Nicronixs/Labor_Oszi/protokoll/Protokoll.pdf

# Aufbau eines eigenen Oszilloskops

### Sonja Schönauer, Nicolas Scherrer 4BHEL

### 26. September 2025

1

## Inhaltsverzeichnis

1 Zielsetzung | 4
2 Blockschaltbild | 5
3 Theoretische Grundlagen | 5
4 Aufbau der Grundschaltung | 8
5 Spannungsquelle VCC kurzgeschlossen | 9
6 Spannungsquelle UE kurzgeschlossen | 10
7 Berechnungen | 11
7.2.2 | UA prufen rechnerisch: | ¨ | 14
7.2.3 | UA prufen mit Simulation: | ¨ | 14
7.3.2 | UA prufen rechnerisch: | ¨ | 17
7.3.3 | UA prufen mit Simulation: | ¨ | 18
7.4.2 | UA prufen rechnerisch: | ¨ | 21
7.4.3 | UA prufen mit Simulation: | ¨ | 22

2

8 Schaltplan | 32

3

## Aufgabenstellung

Entwurf eines analogen Front Ends (AFE) fur ein Oszilloskop, das folgende Ein- ¨ gangssignale verarbeitet:

- ±36 V
- ±10 V
- ±1 V
Die Signale sollen fur einen Mikrocontroller ( ¨ | µC) mit einem ADC-Eingangsspannungsbereich
von 0 V bis 3,3 V aufbereitet werden.

## 1 Zielsetzung

- Skalierung der drei unterschiedlichen Eingangsspannungsbereiche auf eine Ausgangsspannung UA (0 V bis 3,3 V)..
- Signalverschiebung (Offset), um negative Eingangsspannungen in den positiven Spannungen zu wandeln.

4

## 2 Blockschaltbild

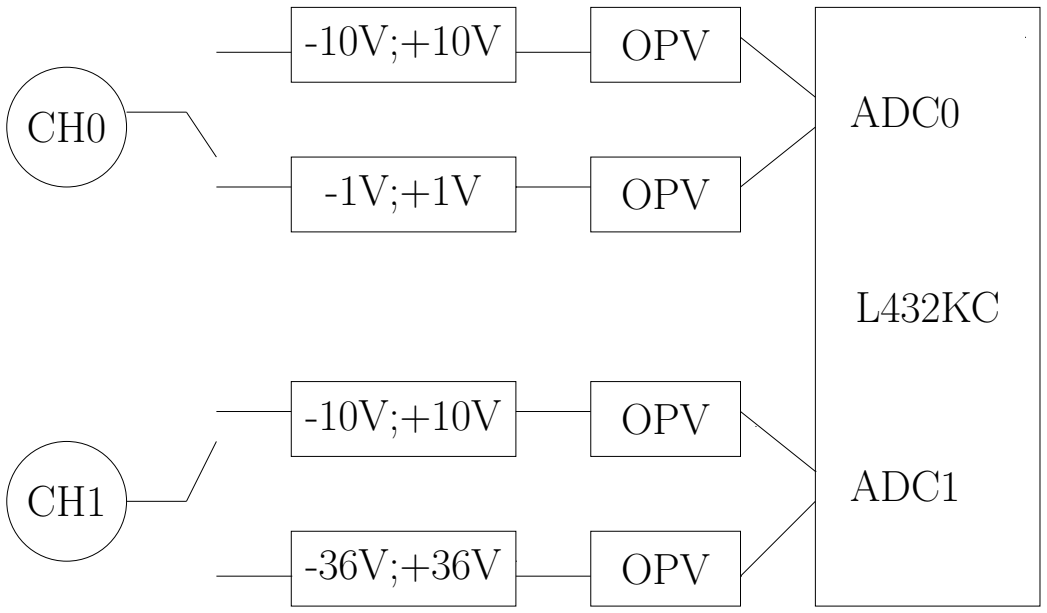
[picture p1: figure]
OPV; ADC0; ADC1

Abbildung 1: Blockdiagramm des Projekts

## 3 Theoretische Grundlagen

### 3.1 Was ist ein Oszilloskop?

Ein Oszilloskop (kurz: Oszi) ist ein Messgerät, das elektrische Spannungsverläufe sichtbar macht. Es zeigt, wie sich eine Spannung in Abhängigkeit von der Zeit verändert. Dadurch können schnelle Signalformen dargestellt und analysiert werden.

### 3.1.1 Was ein Oszilloskop kann

- Spannungsverläufe anzeigen: Darstellung von Sinus-, Rechteck-, Dreiecksignalen, PWM und Störungen.
- Sehr schnelle Signale messen: Moderne digitale Oszilloskope erreichen Abtastraten im Mega- bis Gigahertzbereich.

5

- Signalparameter bestimmen: Messung von Amplitude, Spitzenwert, Spitzen-Spitzen-Wert, Frequenz, Periodendauer, Tastverhältnis, Anstiegs- und Abfallzeiten.
- Mehrere Kanäle gleichzeitig messen: Typischerweise 2 bis 4 Kanäle, High-End-Geräte mehr.
- Signale vergleichen: Eingang und Ausgang eines Systems können gleichzeitig betrachtet werden.
- Triggern: Das Gerät kann Messungen bei bestimmten Ereignissen starten
(z. B. Spannungsuberschreitung). ¨
- Digitale Protokolle dekodieren (moderne Geräte): UART, SPI, I²C usw.

### 3.1.2 Was ein Oszilloskop nicht kann

- Keine direkte Strommessung: Ein Oszilloskop misst grundsätzlich Spannungen. Strommessung nur uber Shunt-Widerstand oder Stromzange. ¨
- Kein Ersatz fur ein Multimeter: ¨ | Es ist nicht fur pr ¨ | äzise Gleichspannungs-
, Widerstands- oder Kapazitätsmessungen gedacht.
- Keine hohen Spannungen ohne Zubehör: Spannungen uber etwa ¨ | ±300 V
benötigen spezielle 10x/100x-Tastköpfe oder Differenzialsonden.
- Zeigt keine idealisierten Werte: Es zeigt reale Rohsignale inklusive Rauschen und Störungen.
- Begrenzte Speicherlänge: Auch Speicheroszilloskope können nur begrenzte Zeitfenster aufzeichnen, abhängig von der Abtastrate.

### 3.2 AFE (Analog-Front-End)

Das Analog Front End (AFE) ist der analoge Signalverarbeitungsteil eines Messsystems, beispielsweise eines Oszilloskops. Es dient der Vorbereitung und Anpassung eines Eingangssignals fur die nachfolgende digitale Verarbeitung, in unse- ¨
rem Fall der ADC eines µC. Das AFE ist somit entscheidend fur die Qualit ¨ | ät der
Messung, da es das Signal optimiert, bevor es digitalisiert wird.

6

### 3.3 Superpositionsprinzip (Helmholtz)

Mit Hilfe des Superpositionsprinzips ist es möglich, die Ausgangsspannung UA zu berechnen. Dabei wird in der Grundschaltung jeweils nur eine Spannungsquelle aktiv gelassen, während alle anderen Spannungsquellen durch einen Kurzschluss ersetzt werden.

UA = U

′
A + U

′′
A
- U
′
A: Ausgangsspannung bei aktiver Quelle UE (mit VCC = 0)
- U
′′
A: Ausgangsspannung bei aktiver Quelle VCC (mit UE = 0)

### 3.4 Spannungsteiler

Mithilfe von Spannungsteilern lassen sich die Ausgangsspannungen bei den jeweiligen aktiven Quellen bestimmen. Durch geeignete Wahl der Widerstandswerte im Spannungsteiler kann die Eingangsspannung so skaliert werden, dass sie innerhalb
des gewunschten Messbereichs (0 V bis 3 ¨ | ,3 V) liegt.

7

## 4 Aufbau der Grundschaltung

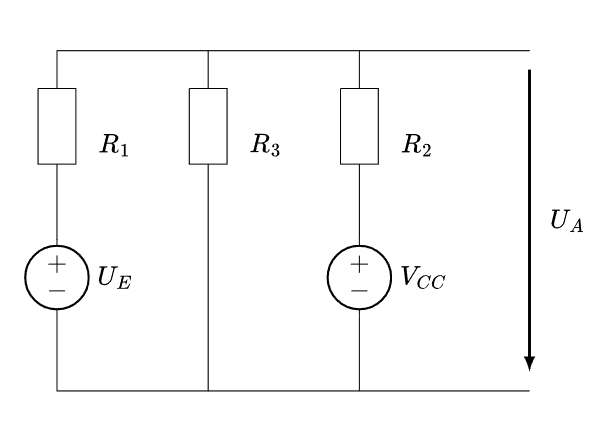
[picture p2: figure]

Abbildung 2: Grundschaltung

8

## 5 Spannungsquelle VCC kurzgeschlossen

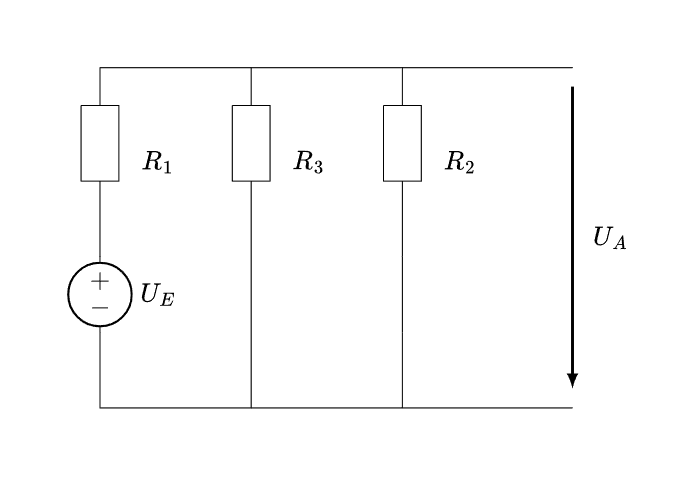
[picture p3: figure]

Abbildung 3: Spannungsquelle VCC kurzgeschlossen

Spannungsteiler:

U

′
A = UE ·

R2 ∥ R3
R1 + (R2 ∥ R3)

Widerstände umschreiben:

R23 =

R2 · R3
R2 + R3

Substitution:

B =

R23
R23 + R1

9

## 6 Spannungsquelle UE kurzgeschlossen

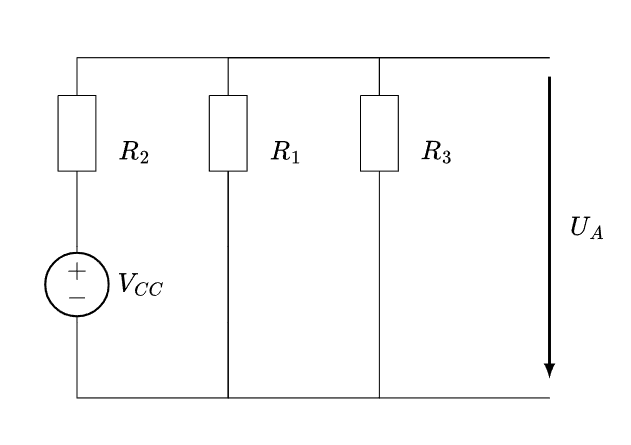
[picture p4: figure]

Abbildung 4: Spannungsquelle UE kurzgeschlossen

Spannungsteiler:

U

′′
A = VCC ·

R1 ∥ R3
R2 + (R1 ∥ R3)

Widerstände umschreiben:

R13 =

R1 · R3
R1 + R3

Substitution:

A =

R13
R13 + R2

10

## 7 Berechnungen

### 7.1 Substitution der Spannungsteiler

Wir ersetzen die Spannungsteiler durch die Variablen A und B:

U

′
A = UE · B
U

′′
A = VCC · A
UA = VCC · A + UE · B

### 7.2 Berechnung fur¨ ±36 V

Gleichungssystem fur¨ A und B:
Die Grenzfälle werden eingesetzt. Wenn eine Eingangspannung UE von +36V anliegt ist unsere Ausgangspannung UA = 3.3V. Wenn eine Eingangspannung UE von -36V anliegt ist unsere Ausgangspannung UA = 0V.

UA = VCC · A + UE · B
I: 3.3 = 3.3 · A + 36 · B
II: 0 = 3.3 · A − 36 · B
⇒ 3.3 · A = 36 · B

⇒ B =

3.3
36
- A = 0.0917 · A

B einsetzen in Gleichung I: 3.3 = 3.3 · A + 36 · 0.0917 · A 3.3 = 3.3 · A + 3.3 · A = 6.6 · A

⇒ A =

3.3
6.6

= 0.5

A einsetzen in die Formel fur B: ¨ ⇒ B = 0.0917 · 0.5 = 0.0458

11

### 7.2.1 Widerstandsberechnung

Bekannte Zusammenhänge:

I : A =

R13
R13 + R2

II : B =

R23
R23 + R1
III : R1 = 1 M − R3

A einsetzen:

I :

R13
R13 + R2

= 0.5

R13 = 0.5(R13 + R2)
R13 = 0.5R13 + 0.5R2
R13 − 0.5R13 = 0.5R2
0.5R13 = 0.5R2

I : R2 = R13 =

R1 · R3
R1 + R3

III in I:

R2 =

R1 · R3
R1 + R3

=

(1 MΩ − R3) · R3
1 MΩ

=

(1 MΩ − R3) · R3
1 MΩ
B einsetzen:

II :

R23
R23 + R1

= 0.0458

0.0458(R1 + R23) = R23
0.0458R1 + 0.0458R23 = R23 | | − 0.0458R23
0.0458R1 = 0.954R23 | |/0.0458

R1 =

0.954
0.0458
- R23

II : R1 = 20.83R23

12

II: umschreiben:

II : R1 = 20.83 ·

R2 · R3
R2 + R3
III in II:

1M − R3 = 20.83 ·

R2 R3
R2 + R3

|(R2 + R3)
1M − R3

R2 + R3
= 20,83 R2 R3
1M − R3
R2 +
1M − R3
R3 = 20.83R2R3 | | − 20.83R2R3

R2

1M − R3
+ R3
1M − R3
− 20.83R2R3 = 0

R2

1M − R3 − 20.83R3
+ R3
1M − R3
= 0 | | − R3
| 1M − R3

R2

1M − R3−20.83R3) = −R3
1M − R3
| |/(1M − R3−20.83R3)

R2 =

−R3

1M − R3
1M − R3
| − 20.83R3

III=II
−R3 (1M − R3)
(1M − R3) − 20.83 R3

=

(1M − R3) R3
1

M

−

1M − R3 − 20.83 R3
= 1M
−1M + R3 + 20.83 R3 = 1M
−1M + 21.83 R3 = 1M | | + 1M
21.83 R3 = 2M | | ÷ 21.83

R3 =

2M
21.83

≈ 91.62 kΩ

R3 = 91 kΩ (E24 genormt)

R1 und R2 berechnen mit R3 = 91 kΩ:

R1 = 1 MΩ − 91 kΩ = 909 kΩ (E24-Näherung: | 910 kΩ | )

R2 =

(1 MΩ − 91 kΩ) · 91 kΩ
1 MΩ | = 82,81 kΩ (E24-Näherung: | 82 kΩ | )

13

### 7.2.2 UA prufen rechnerisch: ¨

UA = UE ·

R2 ∥ R3
R1 + (R2 ∥ R3)

+ VCC ·

R1 ∥ R3
R2 + (R1 ∥ R3)

=

= 3.3V · 0.0458Ω + 36V · 0.5Ω = 3.2991V

### 7.2.3 UA prufen mit Simulation: ¨

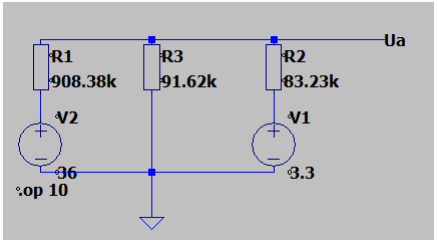
[picture p5: figure]

Abbildung 5: Schaltung fur ¨ UA Uberpr ¨ ufung bei 36V ¨

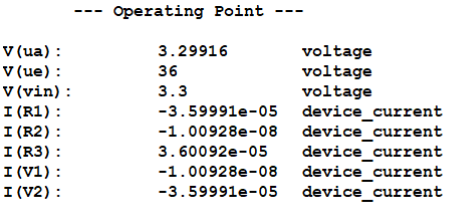
[picture p6: figure]

Abbildung 6: UA bei 36V

14

### 7.3 Berechnung fur¨ ±10 V

Gleichungssystem fur¨ A und B:
Die Grenzfälle werden eingesetzt. Wenn eine Eingangsspannung UE = +10 V anliegt, ist die Ausgangsspannung UA = 3.3 V. Wenn UE = −10 V, dann ist UA = 0 V.

UA = VCC · A + UE · B
I: 3.3 = 3.3 · A + 10 · B
II: 0 = 3.3 · A − 10 · B
⇒ 3.3 · A = 10 · B

⇒ B =

3.3
10
- A = 0.33 · A

B einsetzen in Gleichung I: 3.3 = 3.3 · A + 10 · 0.33 · A 3.3 = 3.3 · A + 3.3 · A = 6.6 · A

⇒ A =

3.3
6.6

= 0.5

A einsetzen in die Formel fur B: ¨ | B = 0.33 · 0.5 = 0.165

### 7.3.1 Widerstandsberechnung

Bekannte Zusammenhänge:

I : A =

R13
R13 + R2

II : B =

R23
R23 + R1
III : R1 = 1M − R3

15

A einsetzen:

I :

R13
R13 + R2

= 0.5

R13 = 0.5(R13 + R2)
R13 = 0.5R13 + 0.5R2
R13 − 0.5R13 = 0.5R2
0.5R13 = 0.5R2

I :⇒ R2 = R13 =

R1 · R3
R1 + R3

III in I:

R2 =

(1M − R3) · R3
1M

B einsetzen:

II :

R23
R23 + R1

= 0.165

0.165(R1 + R23) = R23
0.165R1 + 0.165R23 = R23
0.165R1 = 0.835R23

R1 =

0.835
0.165
- R23

II :⇒ R1 = 5.06 · R23

II umschreiben:
R1 = 5.06 ·

R2 · R3
R2 + R3
III in II:

1M − R3 = 5.06 ·

R2 · R3
R2 + R3

| · (R2 + R3)

(1M − R3)(R2 + R3) = 5.06 · R2 · R3
(1M − R3)R2 + (1M − R3)R3 = 5.06 · R2 · R3 | | − 5.06 · R2 · R3
R2(1M − R3 − 5.06R3) + R3(1M − R3) = 0 | | − R3(1M − R3)
R2(1M − R3 − 5.06R3) = −R3(1M − R3) | |/(1M − R3 − 5.06R3)

⇒ R2 =

−R3(1M − R3)
(1M − R3 − 5.06R3)

16

III = II:

−R3(1M − R3)
(1M − R3 − 5.06R3)

=

(1M − R3) · R3
1M

|/(1M − R3) · R3

−

1M − R3 − 5.06 R3
= 1M
−1M + R3 + 5.06 R3 = 1M
−1M + 6.06 R3 = 1M | | + 1M
6.06 R3 = 2M

⇒ R3 =

2M
6.06

≈ 330 kΩ

Berechnung der restlichen Widerstände:

R1 = 1M − R3 = 670 kΩ

R2 =

(1M − R3) · R3
1M

= 221,1 kΩ

Gewählte Werte gemäß E24:

R3 = | 330 kΩ
R1 = | 680 kΩ
R2 = | 220 kΩ

### 7.3.2 UA prufen rechnerisch: ¨

UA = UE ·

R2 ∥ R3
R1 + (R2 ∥ R3)

+ VCC ·

R1 ∥ R3
R2 + (R1 ∥ R3)
= 10 V · 0.165 + 3.3 V · 0.5 = 3,28 V

17

### 7.3.3 UA prufen mit Simulation: ¨

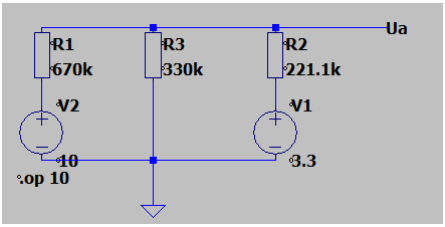
[picture p7: figure]

Abbildung 7: Schaltung fur ¨ UA Uberpr ¨ ufung bei 10V ¨

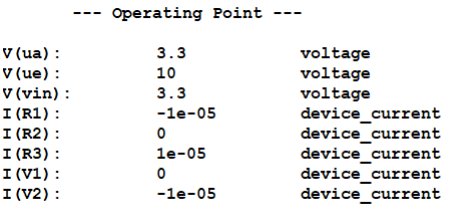
[picture p8: figure]

Abbildung 8: UA Spannung bei 10V

18

### 7.4 Berechnung fur¨ ±1 V

Gleichungssystem fur¨ A und B:
Die Grenzfälle werden eingesetzt. Wenn eine Eingangsspannung UE = +1 V anliegt, ist die Ausgangsspannung UA = 1.1 V. Wenn UE = −1 V, dann ist UA = 0 V.

UA = VCC · A + UE · B
I: 1.1 = 3.3 · A + 1 · B
II: 0 = 3.3 · A − 1 · B
⇒ B = 3.3 · A

B einsetzen in Gleichung II: 1.1 = 3.3 · A + 3.3 · A 3.3 = 3.3 · A + 3.3 · A = 6.6 · A

⇒ A =

1.1
6.6

=

1
6
A einsetzen in die Formel fur B: ¨ | B = 3.3 ·

1
6

= 0.55

### 7.4.1 Widerstandsberechnung

Bekannte Zusammenhänge:

I : A =

R13
R13 + R2

II : B =

R23
R23 + R1
III : R1 = 1M − R3

19

A einsetzen:

I :

R13
R13 + R2

=

1
6

R13 =

1
6

(R13 + R2)

R13 =

1
6

R13 +

1
6

R2

R13 −

1
6

R13 =

1
6

R2

5
6

R13 =

1
6

R2

I :⇒ R2 = 5 · R13 = 5 ·

R1 · R3
R1 + R3

B einsetzen:

II :

R23
R23 + R1

= 0.55

0.55(R1 + R23) = R23
0.55R1 + 0.55R23 = R23
0.55R1 = 0.45R23

R1 =

0.45
0.55
- R23

II :⇒ R1 = 0.818 · R23

II umschreiben:
R1 = 0.818 ·

R2 · R3
R2 + R3
III in II:

1M − R3 = 0.818 ·

R2 · R3
R2 + R3

| · (R2 + R3)

(1M − R3)(R2 + R3) = 0.818 · R2 · R3
(1M − R3)R2 + (1M − R3)R3 = 0.818 · R2 · R3 | | − 0.818 · R2 · R3| − R3(1M − R3)
R3(1M − R3) − 0.818 · R2 · R3 = −R3(1M − R3)
R2(1M − R3 − 0.818R3) = −R3(1M − R3) | |/(1M − R3 − 0.818R3)

⇒ R2 =

−R3(1M − R3)
(1M − R3 − 0.818R3)

20

III = II:

−R3(1M − R3)
(1M − R3 − 0.818R3)

= 5 ·

(1M − R3) · R3
1M

|/(1M − R3) · R3

−

1M − R3 − 0.818 R3
=

1M
5
−1M + R3 + 0.818 R3 = 200k
−1M + 1.818 R3 = 200k | | + 1M
1.818 R3 = 1.2M

⇒ R3 =

1.2M
1.818

= 660 kΩ

R3 = 680 kΩ

R1 und R2 berechnen:

R1 = 1M − R3 = 340 kΩ

R2 =

(1M − R3) · R3
1M

= 1,122 MΩ

E24-Näherungen:

R1 = | 360 kΩ | (nächster E24-Wert)
R2 = | 1,2 MΩ | (nächster E24-Wert)

### 7.4.2 UA prufen rechnerisch: ¨

UA = UE ·

R2 ∥ R3
R1 + (R2 ∥ R3)

+ VCC ·

R1 ∥ R3
R2 + (R1 ∥ R3)

= 1 V · 0.55 + 3.3 V ·

1
6

= 1,1 V

21

### 7.4.3 UA prufen mit Simulation: ¨

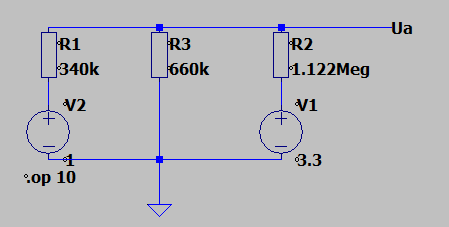
[picture p9: figure]

Abbildung 9: Schaltung fur ¨ UA Uberpr ¨ ufung bei 1V ¨

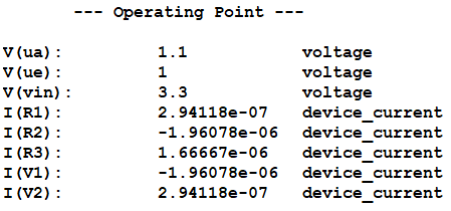
[picture p10: figure]

Abbildung 10: UA Spannung bei 1V

22

### 7.5 OPV

### 7.5.1 Nicht-invertierender Verstärker

Zur Anpassung des Signals vom Eingangskanal, welcher eine Spannung von ±1 V liefert, an die benötigte Eingangsspannung des Mikrocontrollers von 3,3 V verwenden wir einen nicht-invertierenden Verstärker.
Der nicht-invertierende Verstärker eignet sich hierfur besonders, da er das Ein- ¨ gangssignal phasengleich verstärkt, das heißt ohne Phasenumkehr, und gleichzeitig eine hohe Eingangsimpedanz besitzt. Dadurch wird das Signal kaum belastet, was eine präzise Spannungsverstärkung ermöglicht.
Fur unser Signal von ¨ | ±1 V benötigen wir eine Verstärkung von etwa 3,3, um
das Signal auf den Mikrocontroller-gerechten Pegel von ±3,3 V anzuheben. Durch diese Verstärkung ist sichergestellt, dass der Mikrocontroller das Signal im optimalen Messbereich erhält, wodurch sowohl eine präzise Verarbeitung als auch eine maximale Ausnutzung des ADC-Eingangs ermöglicht wird.

### 7.5.2 Verstärker-Schaltung

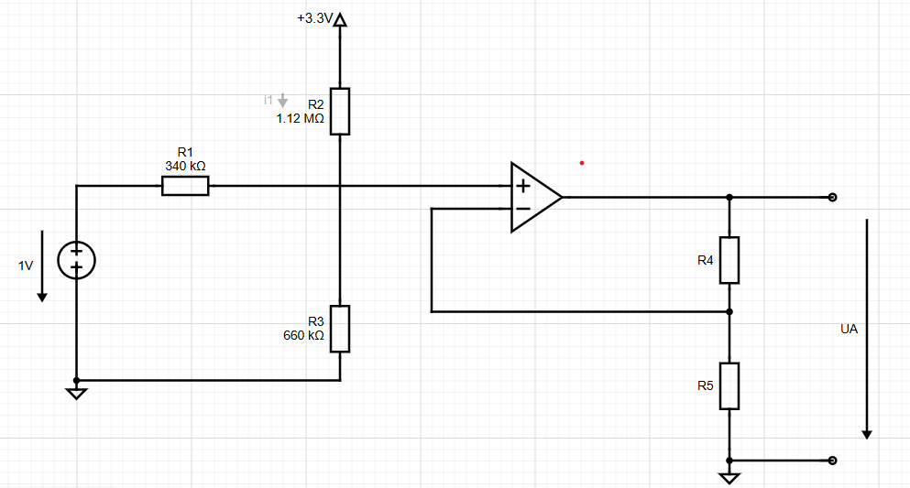
[picture p11: figure]

Abbildung 11: Verstärker Schaltung fur ¨ ±1 V

23

7.5.3 | Berechnungen fur die Verst ¨ | ärker-Schaltung

Gegeben:
| | −1 V ⇒ 0 V, +1 V ⇒ 3,3 V,
| | R1 = 340 kΩ, R2 = 1,12 MΩ, R3 = 660,066 kΩ,

Angenommen:
| | Rh = 20 kΩ.
Fur den nichtinvertierenden Verst ¨ | | ärker gilt:
| | V = 1 + R4 R5 = Ua Ue .

Daraus folgt:
Ua
Ue
| | − 1 = R4 R5 .

Umgestellt nach R5:

R5 =

| | R4 Ua Ue − 1 .

Einsetzen der Werte:

| R5 =

20 kΩ

3,3
1 − 1

=

| | 20 kΩ
| | 2,3 = 8,696 kΩ.

R5 = 8,7 kΩ

24

### 7.6 Vergleichen von Messdaten und Simulationsdaten

### 7.6.1 Gemessen bei ±10 V

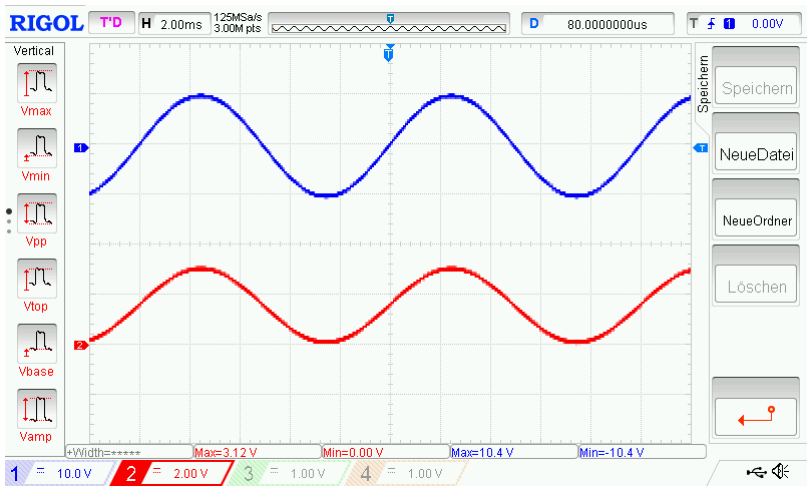
[picture p12: figure]

Abbildung 12: Oszilloskop-Signal bei einer Ausgangsspannung von ±10 V

Blau: Eingang Rot: Ausgang

25

### 7.6.2 Simulation bei ±10 V

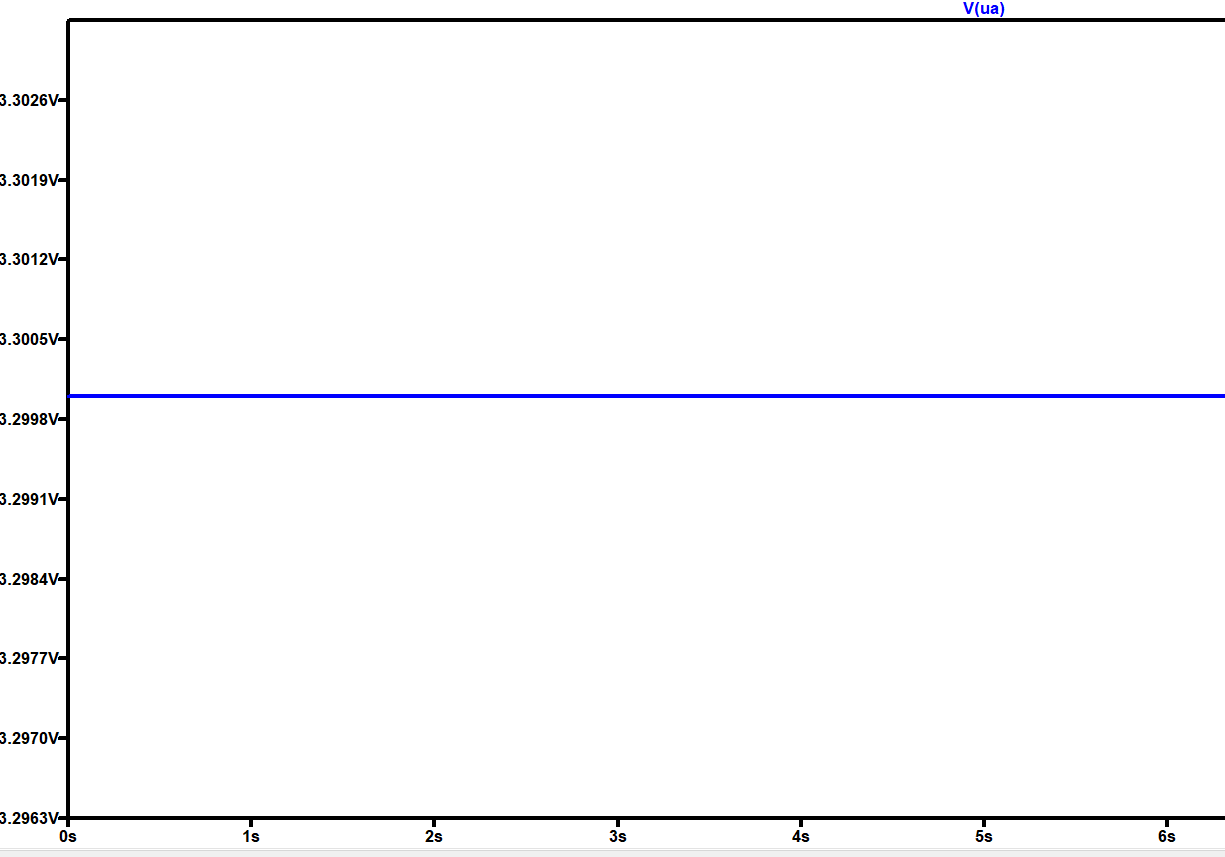
[picture p13: figure]

Abbildung 13: Simulations-Signal bei einer Eingangsspannung von ±10 V

Die dargestellten Messergebnisse stimmen mit den zuvor durchgefuhrten Simu- ¨ lationen und Berechnungen uberein. ¨
Ergebnis der Berechnung: UA = 3,28V
Ergebnis der Simulation: UA = 3,3V
Ergebnis der Messung am Oszilloskop: UA = 3,12V

26

### 7.6.3 Schaltung mit ±1 V

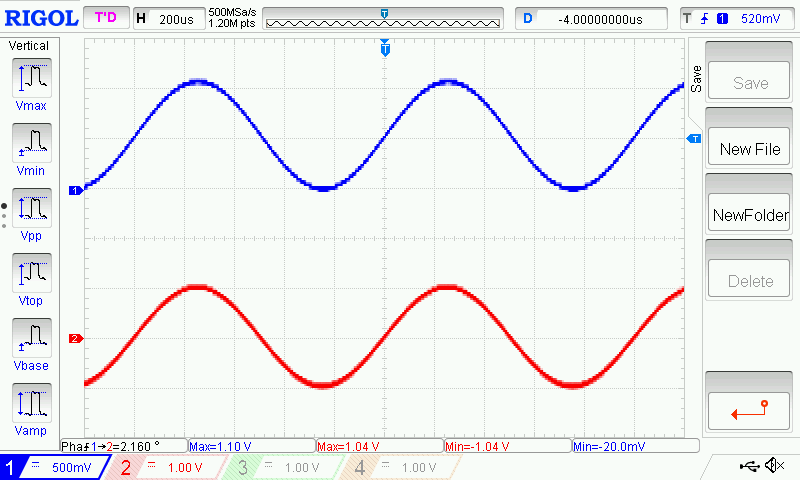
[picture p14: figure]

Abbildung 14: Oszilloskop bei UE = ±1 V

Blau: Ausgang Rot: Eingang

27

### 7.6.4 Simulation bei ±1 V

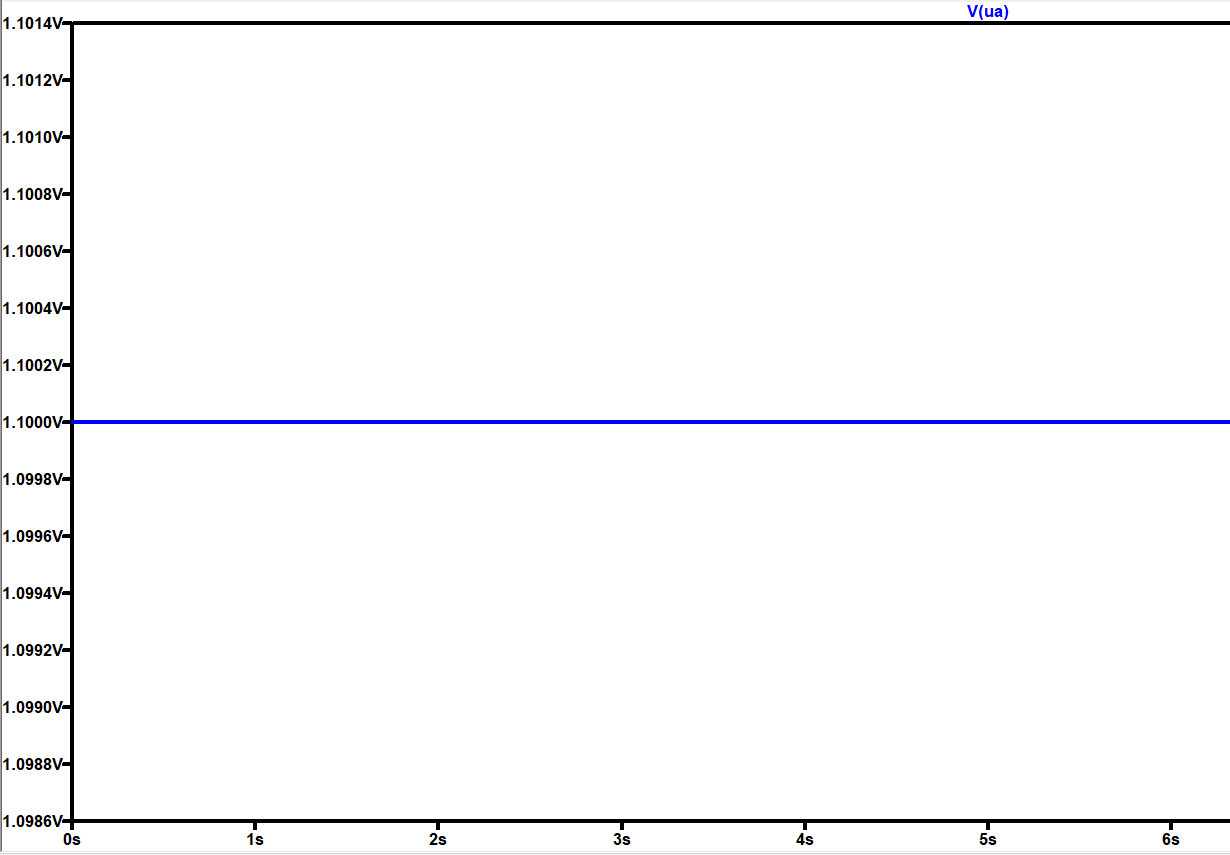
[picture p15: figure]

Abbildung 15: Simualtion bei UE = ±1 V

Die dargestellten Messergebnisse stimmen mit den zuvor durchgefuhrten Simu- ¨ lationen und Berechnungen uberein. ¨
Ergebnis der Berechnung: UA = 1,1V
Ergebnis der Simulation: UA = 1,1V
Ergebnis der Messung am Oszilloskop: UA = 1,1V

28

### 7.6.5 Schaltung mit ±1 V und OPV

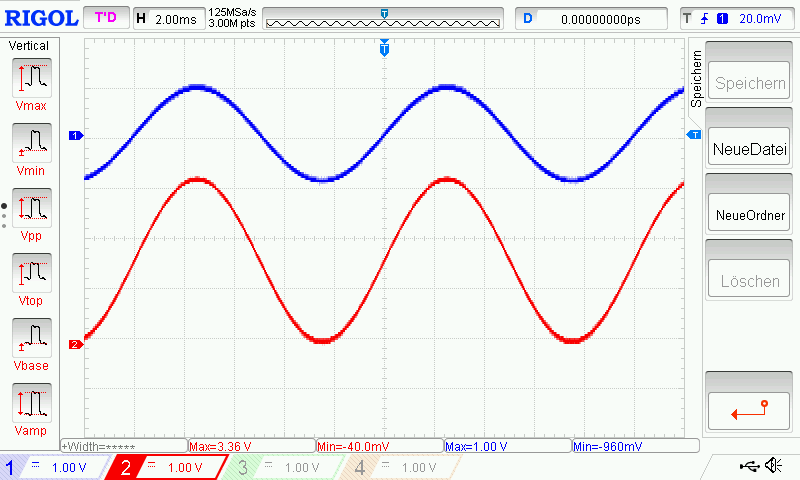
[picture p16: figure]

Abbildung 16: Oszilloskop-Signal bei einer Eingangsspannung von 1,840 Vpp

Blau: Eingang Rot: Ausgang

29

### 7.6.6 Simulation mit ±1 V und OPV

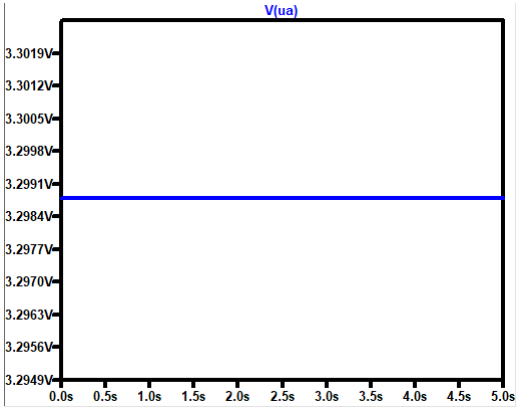
[picture p17: figure]

Abbildung 17: Simualtion bei UE = ±1 V mit OPV

Um ein abgeschnittenes Signal am Ausgang Ua zu vermeiden, speisen wir eine Eingangsspannung von 1,840 Vpp vom Funktionsgenerator in das Oszilloskop ein. Der Einsatz eines Operationsverstärkers sorgt dafur, dass das Signal ausreichend ¨ verstärkt und verzerrungsfrei dargestellt wird.

30

### 7.6.7 Schaltung mit ±36 V

Die Messung mit dem Funktionsgenerator war in diesem Fall nicht möglich, da dieser nur Eingangsspannungen bis maximal ±20 V (entspricht 40 V peak-to-peak)
erzeugen kann. Fur unsere Anwendung w ¨ | äre jedoch eine Spannung von ±36 V
erforderlich, was 72 V peak-to-peak entspricht.
Ein Ansatz, dieses Problem zu umgehen, bestand darin, die Ausgangsspannung des Funktionsgenerators mithilfe eines Operationsverstärkers (OPV) zu verstärken. Hierfur wurde der MCP6002 verwendet. Allerdings war dies nicht erfolgreich, da ¨ dieser OPV lediglich eine Versorgungsspannung von maximal 6 V unterstutzt und ¨ somit nicht in der Lage ist, die erforderliche Ausgangsspannung bereitzustellen.

### 7.6.8 Simulation mit ±36 V

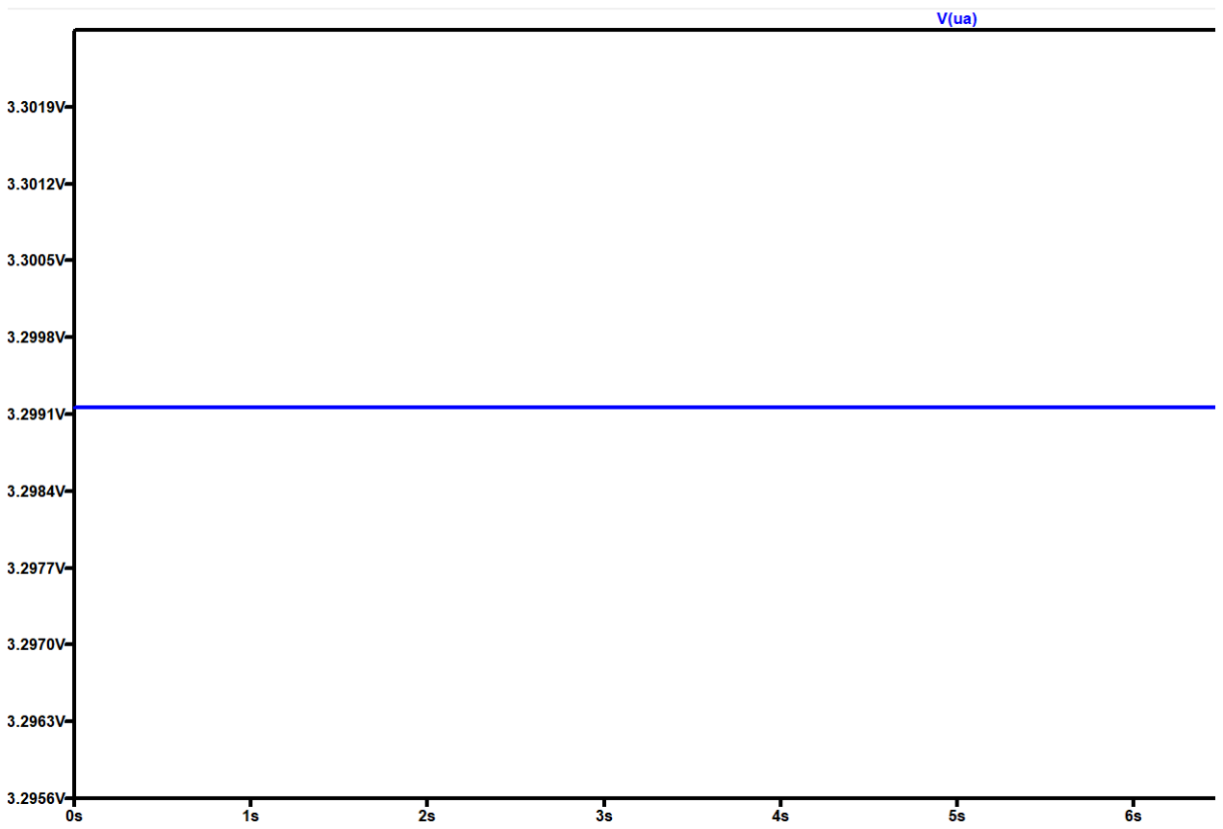
[picture p18: figure]

Abbildung 18: Simulation bei UE = ±36 V

31

## 8 Schaltplan

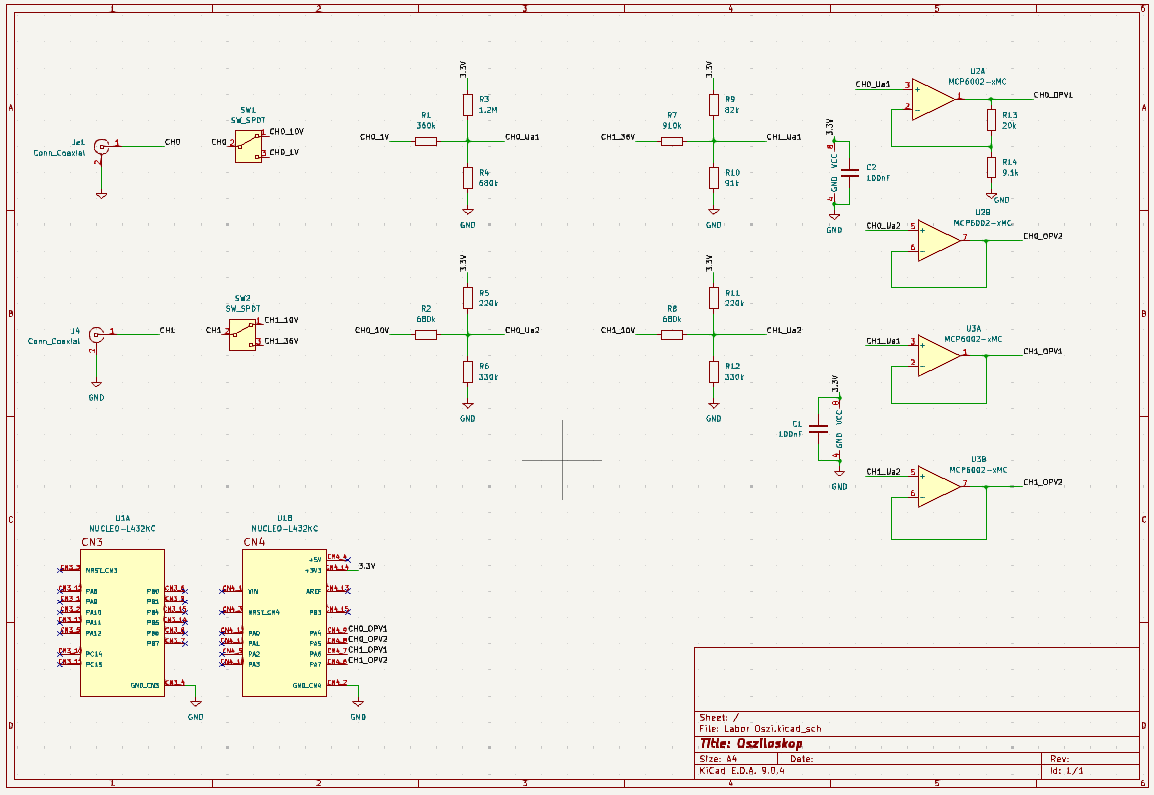
[picture p19: figure]

Abbildung 19: Schaltung in KiCad fur das Layout ¨

### 8.1 Erklärung des Schaltplans

### 8.1.1 Eingänge

Die zwei Eingänge (Je1 und J4) sind jeweils als koaxiale Anschlusse ¨ (Conn Coaxial) ausgelegt und mit den Kanälen beschriftet:

- CH0
- CH1

Diese Eingänge dienen dazu, unterschiedliche Spannungssignale von Messpunkten oder Sensoren aufzunehmen.

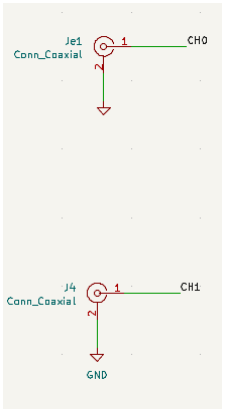
[picture p20: figure]

Abbildung 20: koaxiale Anschlusse ¨

33

### 8.1.2 Schalter

Mit den Schaltern (SW1 und SW2) kann man zwischen den verschiedernen Eingangsspannungen variieren.

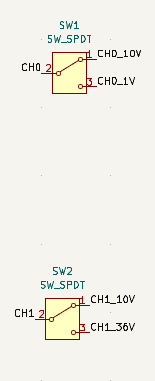
[picture p21: figure]

Abbildung 21: Schalter Schaltung

34

### 8.1.3 Spannungsteiler

Jeder Eingang wird durch einen Spannungsteiler (R1–R14) angepasst, der die hohe Eingangsspannung auf ein niedrigeres, sicheres Spannungsniveau heruntersetzt, das mit dem Mikrocontroller kompatibel ist.

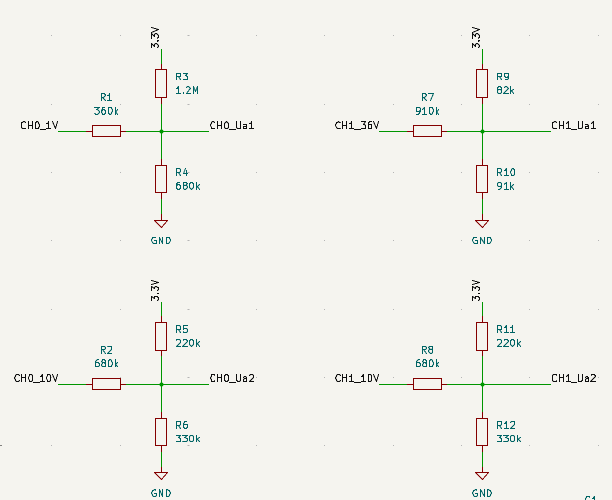
[picture p22: figure]

Abbildung 22: Spannungsteiler Schaltung

35

### 8.1.4 Kondesatoren

Die Kondensatoren dienen als Buffer zwischen Vcc und GND um das signal nicht zu verfälschen.

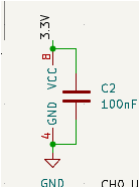
[picture p23: figure]

Abbildung 23: Kondensator Schaltung

36

### 8.1.5 OPV

Fur die Signale gibt es je einen Verst ¨ | ärker-Abschnitt mit dem Operations-
verstärker MCP6002 (U1A bis U4A). Diese OPVs sind als nicht-invertierende Verstärker geschaltet, um die Signale weiter zu verstärken bzw. zu puffern und an die ADC-Eingänge des Mikrocontrollers anzupassen.

Abbildung 24: OPV Schaltung

37

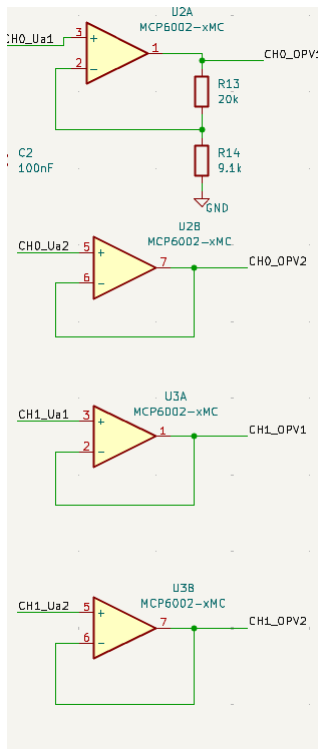
[picture p24: figure]

### 8.1.6 µC

U5A und U5B sind die beiden Mikrocontroller-Module (NUCLEO-L432KC), welche die analogen Signale von den Verstärkern digitalisieren.

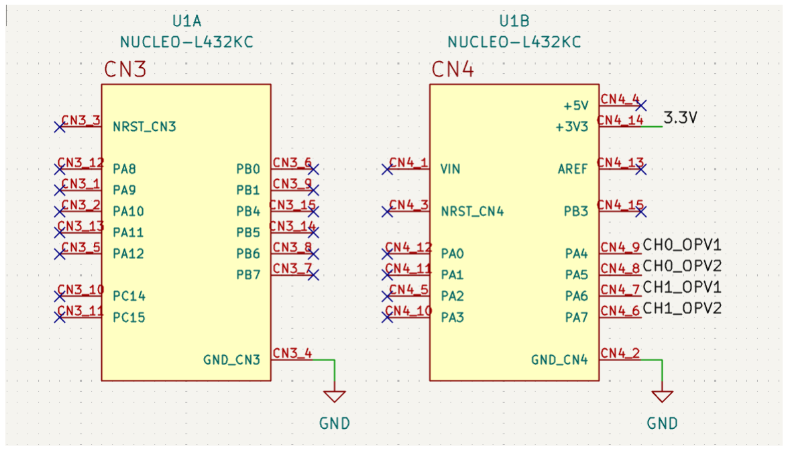
[picture p25: figure]

Abbildung 25: µC Schaltung

38
