Nicronixs/Labor_Oszi/design/CONBNC001/CONBNC001.step

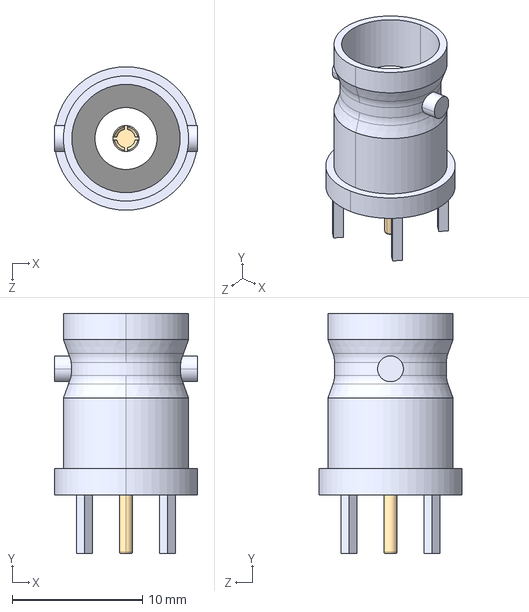
[picture p26: CAD file, 2025-11-30]
design/CONBNC001/CONBNC001.step
11.0 x 18.4 x 11.0 mm
