Nicronixs/Labor_Oszi/design/Labor Oszi.kicad_pcb

## KiCad design design/Labor Oszi.kicad_pcb (2025-12-12)

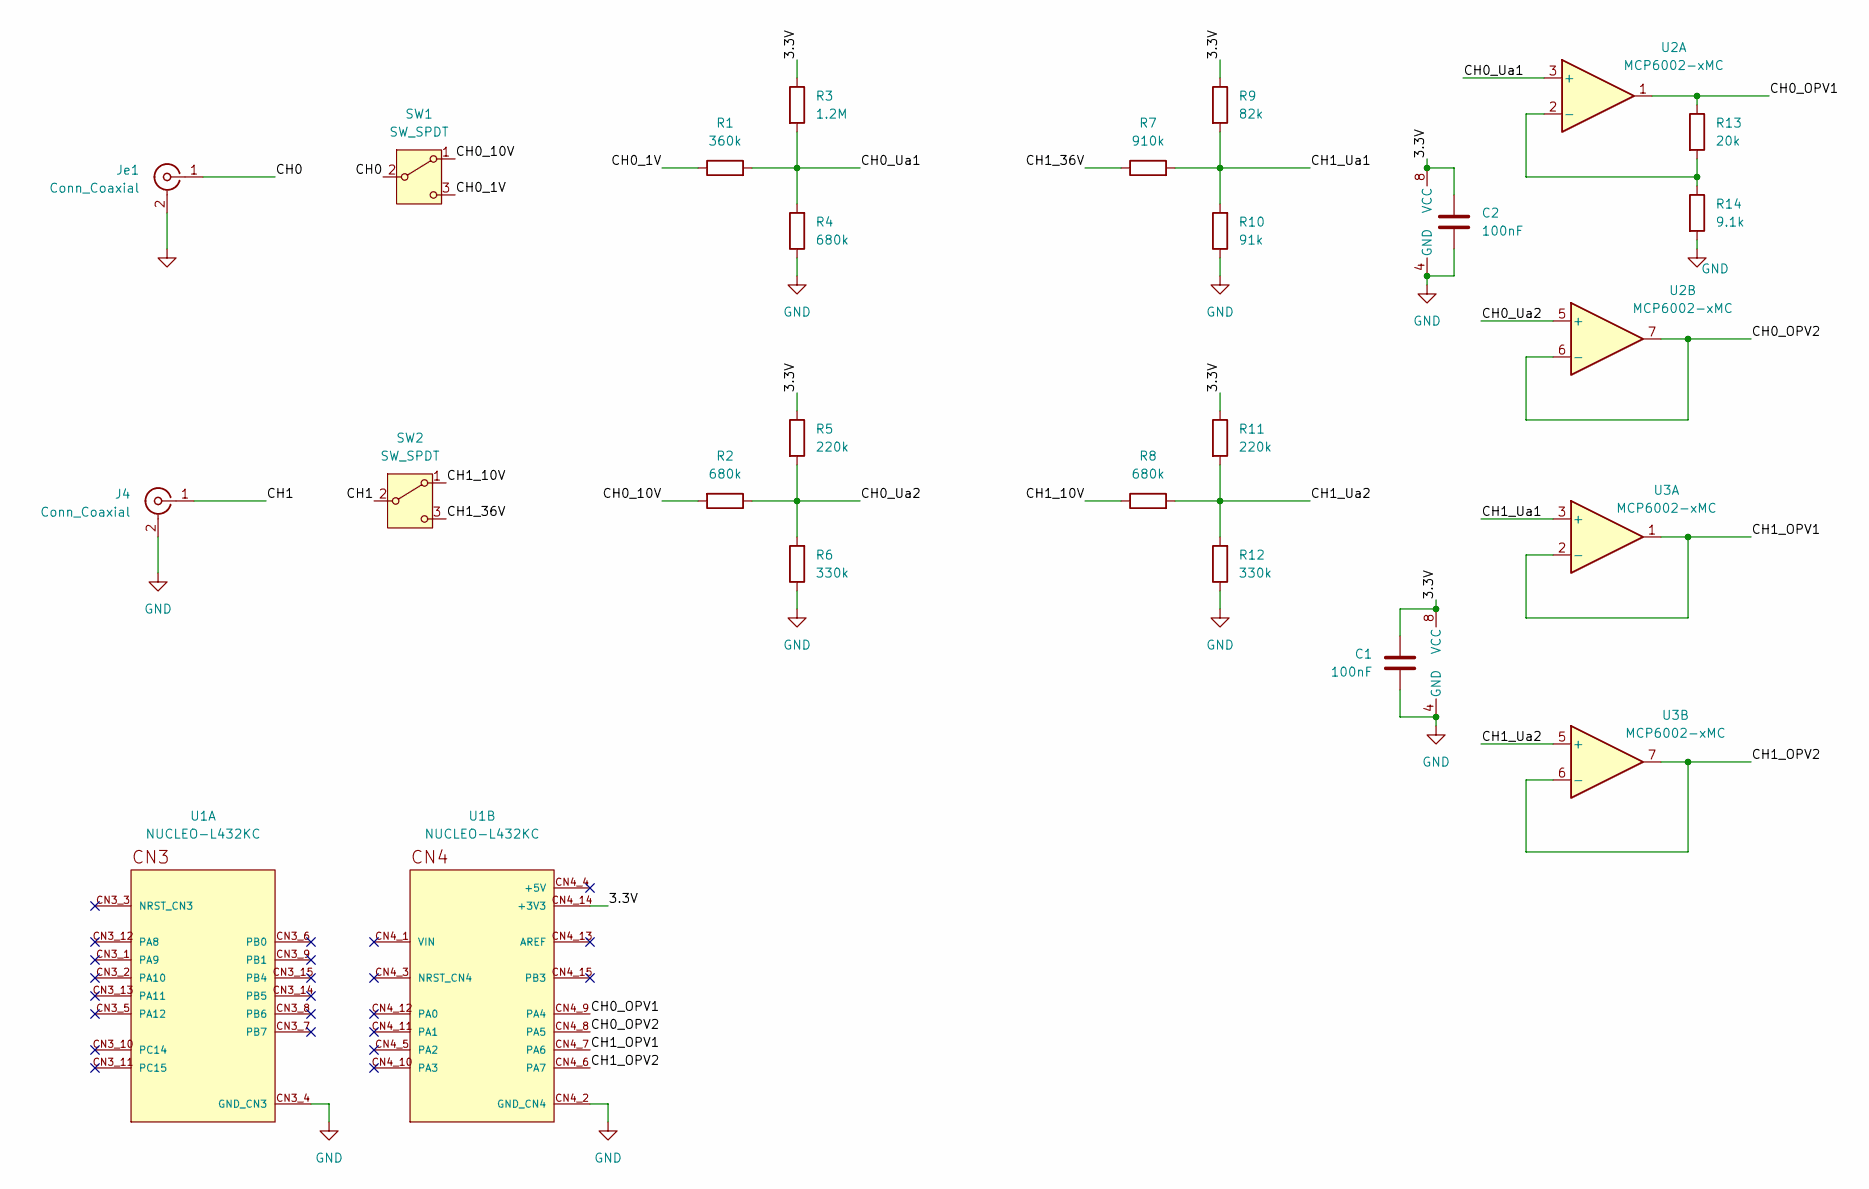
[picture p27: schematic Labor Oszi.kicad_sch, Oszilloskop]

Parts:
C1, C2: 100nF; C_0603_1608Metric_Pad1.08x0.95mm_HandSolder; LCSC Part # C14663
J4: Conn_Coaxial; LINX_CONBNC001
Je1: Conn_Coaxial; LINX_CONBNC001
R1: 360k; R_0603_1608Metric_Pad0.98x0.95mm_HandSolder; LCSC Part # C23146
R2, R4, R8: 680k; R_0603_1608Metric_Pad0.98x0.95mm_HandSolder; LCSC Part # C25822
R3: 1.2M; R_0603_1608Metric_Pad0.98x0.95mm_HandSolder; LCSC Part # C22107
R5, R11: 220k; R_0603_1608Metric_Pad0.98x0.95mm_HandSolder; LCSC Part # C22961
R6, R12: 330k; R_0603_1608Metric_Pad0.98x0.95mm_HandSolder; LCSC Part # C23137
R7: 910k; R_0603_1608Metric_Pad0.98x0.95mm_HandSolder; LCSC Part # C23263
R9: 82k; R_0603_1608Metric_Pad0.98x0.95mm_HandSolder; LCSC Part # C23254
R10: 91k; R_0603_1608Metric_Pad0.98x0.95mm_HandSolder; LCSC Part # C23265
R13: 20k; R_0603_1608Metric_Pad0.98x0.95mm_HandSolder; LCSC Part # C4184
R14: 9.1k; R_0603_1608Metric_Pad0.98x0.95mm_HandSolder; LCSC Part # C23260
SW1, SW2: SW_SPDT; SW_SPDT_PCM12
U1: NUCLEO-L432KC; MODULE_NUCLEO-L432KC; PARTREV N/A
U2, U3: MCP6002-xMC; DFN-8-1EP_3x2mm_P0.5mm_EP1.75x1.45mm; LCSC Part # C185041

Connections:
/3.3V: C1.1, C2.1, R3.1, R5.1, R9.1, R11.1, U1.CN4_14 (+3V3), U2.8 (VCC), U3.8 (VCC)
/CH0: Je1.1 (In), SW1.2 (B)
/CH0_1V: R1.1, SW1.3 (C)
/CH0_10V: R2.2, SW1.1 (A)
/CH0_OPV1: R13.1, U1.CN4_9 (PA4), U2.1
/CH0_OPV2: U1.CN4_8 (PA5), U2.6 (-), U2.7
/CH0_Ua1: R1.2, R3.2, R4.2, U2.3 (+)
/CH0_Ua2: R2.1, R5.2, R6.2, U2.5 (+)
/CH1: J4.1 (In), SW2.2 (B)
/CH1_10V: R8.1, SW2.1 (A)
/CH1_36V: R7.1, SW2.3 (C)
/CH1_OPV1: U1.CN4_7 (PA6), U3.1, U3.2 (-)
/CH1_OPV2: U1.CN4_6 (PA7), U3.6 (-), U3.7
/CH1_Ua1: R7.2, R9.2, R10.2, U3.3 (+)
/CH1_Ua2: R8.2, R11.2, R12.2, U3.5 (+)
GND: C1.2, C2.2, J4.2 (Ext), Je1.2 (Ext), R4.1, R6.1, R10.1, R12.1, R14.2, U1.CN3_4 (GND_CN3), U1.CN4_2 (GND_CN4), U2.4 (GND), U3.4 (GND)
unnamed: R13.2, R14.1, U2.2 (-)

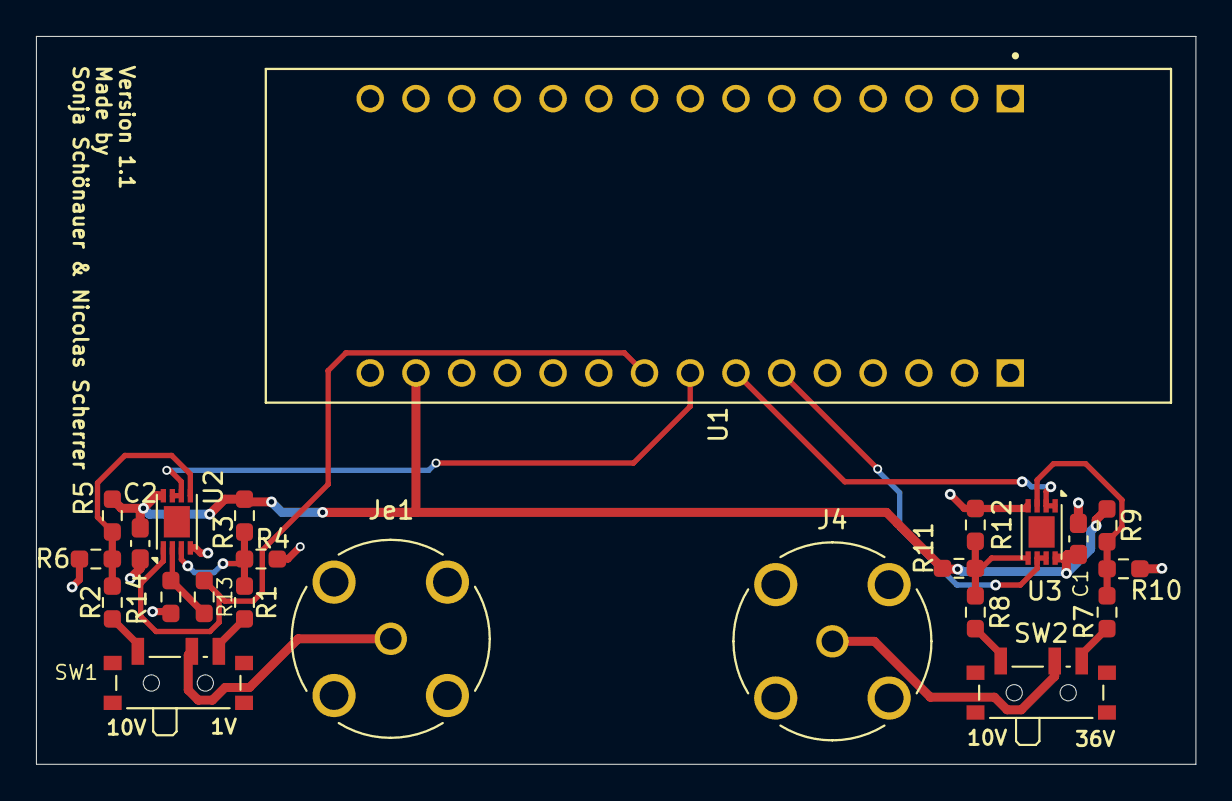
[picture p28: board Labor Oszi.kicad_pcb from above]

Board: 2 copper layers, 64.4 x 40.4 mm, 23 parts (0 on the bottom side), 17 nets.
