Nicronixs/Labor_Oszi/code/stm.v.1.0/Labor/Core/Src/main.c

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
/* Includes ------------------------------------------------------------------*/
#include "main.h"
#include "adc.h"
#include "usart.h"
#include "gpio.h"

/* USER CODE BEGIN Includes */
#include <string.h>
#include <stdio.h>
#include <stdint.h>
/* USER CODE END Includes */


/* USER CODE BEGIN PV */


#define ADC_RESOLUTION      4095.0f
#define VREF                3.3f

#define SCALE_CH0_LOW    1.0f    // CH0 → 1V Bereich
#define SCALE_CH0_HIGH   10.0f   // CH0 → 10V Bereich

#define SCALE_CH1_LOW    10.0f   // CH1 → 10V Bereich
#define SCALE_CH1_HIGH   36.0f   // CH1 → 36V Bereich

// DMA/ADC Buffer
volatile uint16_t adcValues[4]; // [PA4, PA5, PA6, PA7]
volatile uint8_t adcReady = 0;  // gesetzt im Callback
/* USER CODE END PV */

void SystemClock_Config(void);
/**
  * @brief  The application entry point.
  * @retval int
  */
int main(void)
{

  /* MCU Configuration--------------------------------------------------------*/

  /* Reset of all peripherals, Initializes the Flash interface and the Systick. */
  HAL_Init();

  /* Configure the system clock */
  SystemClock_Config();

  /* Initialize all configured peripherals */
  MX_GPIO_Init();
  MX_USART2_UART_Init();
  MX_ADC1_Init();

  /* USER CODE BEGIN 2 */

  // Start ADC in DMA mode (4 channels)
  if (HAL_ADC_Start_DMA(&hadc1, (uint32_t*)adcValues, 4) != HAL_OK)
  {
      Error_Handler();
  }
  /* USER CODE END 2 */

  /* Infinite loop */
  /* USER CODE BEGIN WHILE */

  while (1)
  {
	  if (adcReady)
	    {
	        adcReady = 0;

	        // Rohwerte in ADC-Spannung umrechnen (0..VREF)
	        float va = (float)adcValues[0] * VREF / ADC_RESOLUTION; // PA4 (CH0 low)
	        float vb = (float)adcValues[1] * VREF / ADC_RESOLUTION; // PA5 (CH0 high)
	        float vc = (float)adcValues[2] * VREF / ADC_RESOLUTION; // PA6 (CH1 low)
	        float vd = (float)adcValues[3] * VREF / ADC_RESOLUTION; // PA7 (CH1 high)

	        // Threshold zur Bereichserkennung
	        const float THRESH = 0.05f;
	        char buffer[128];
	        int len = 0; // vorab deklarieren

	        // CH0: wähle aktiven Bereich
	        float CH0;
	        if (va > THRESH)
	        {
	            CH0 = va * SCALE_CH0_LOW;
	            len = snprintf(buffer, sizeof(buffer), "%.6f\n", CH0);
	        }
	        if (vb > THRESH)
	        {
	            CH0 = vb * SCALE_CH0_HIGH;
	            len = snprintf(buffer, sizeof(buffer), "%.6f\n", CH0);
	        }

	        // CH1: wähle aktiven Bereich
	        float CH1;
	        if (vc > THRESH)
	        {
	            CH1 = vc * SCALE_CH1_LOW;
	            len += snprintf(buffer + len, sizeof(buffer) - len, "%.6f\n", CH1);
	        }
	        if (vd > THRESH)
	        {
	            CH1 = vd * SCALE_CH1_HIGH;
	            len += snprintf(buffer + len, sizeof(buffer) - len, "%.6f\n", CH1);
	        }

	        HAL_UART_Transmit(&huart2, (uint8_t*)buffer, len, 20);
	    }



  }


    /* USER CODE END WHILE */


    /* USER CODE BEGIN 3 */

  }
  /* USER CODE END 3 */


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
/* USER CODE BEGIN 4 */
void HAL_ADC_ConvCpltCallback(ADC_HandleTypeDef* hadc)
{
    if(hadc->Instance == ADC1)
    {
        // Eine komplette Gruppe von 4 Messwerten ist verfügbar
        adcReady = 1;
    }
}
/* USER CODE END 4 */
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
