Nicronixs/Labor_Oszi/code/stm.v.1.0/Labor/Labor.ioc

Mcu.UserName=STM32L432KCUx
PA0.GPIO_Label=MCO [High speed clock in]
PA0.Signal=RCC_CK_IN
PA2.GPIO_Label=VCP_TX
PA2.Signal=USART2_TX
PA4.Signal=ADCx_IN9
PA5.Signal=ADCx_IN10
PA6.Signal=ADCx_IN11
PA7.Signal=ADCx_IN12
