Nicronixs/Labor_Oszi/(commit log)

2025-12-05 Python Plotten
    [bom_mouser.csv]
2025-12-05 stm32 code
2025-12-12 Schaltplan Revision
    [Labor Oszi.kicad_sch, bom.csv]
2025-12-12 minor Part changes & Folder Structure fixes
    [Labor Oszi.kicad_sch, bom.csv]
2025-12-12 minor changes on the pcb
    [Labor Oszi.kicad_pcb, bom_mouser.csv, designators.csv, positions.csv]
