Nicronixs/Labor_Oszi/(notices)

Notices in the files:
code/stm.v.1.0/Labor/Core/Src/adc.c:
Copyright (c) 2025 STMicroelectronics.
All rights reserved.
This software is licensed under terms that can be found in the LICENSE file
